Bluefish5/Nano/Documents/PCB schematic/PROC NANO.png

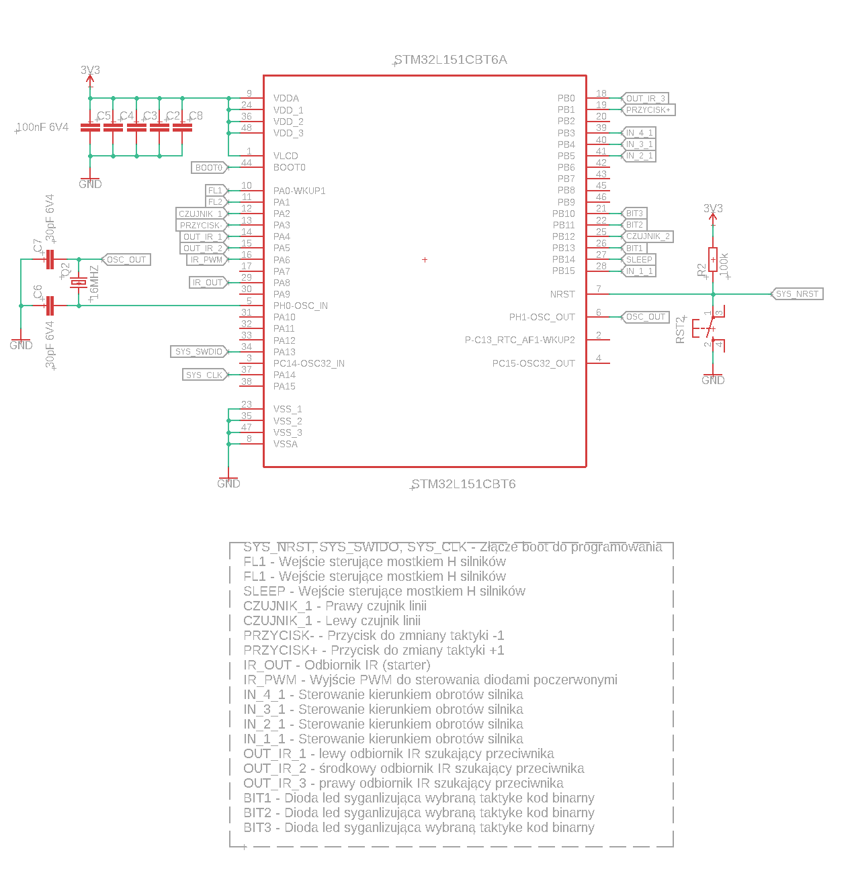
Documents/PCB schematic/PROC NANO.png
