Bluefish5/Nano/Documents/PCB schematic/PCB-dol.brd

## EAGLE design Documents/PCB schematic/PCB-dol.brd (2022-12-02)

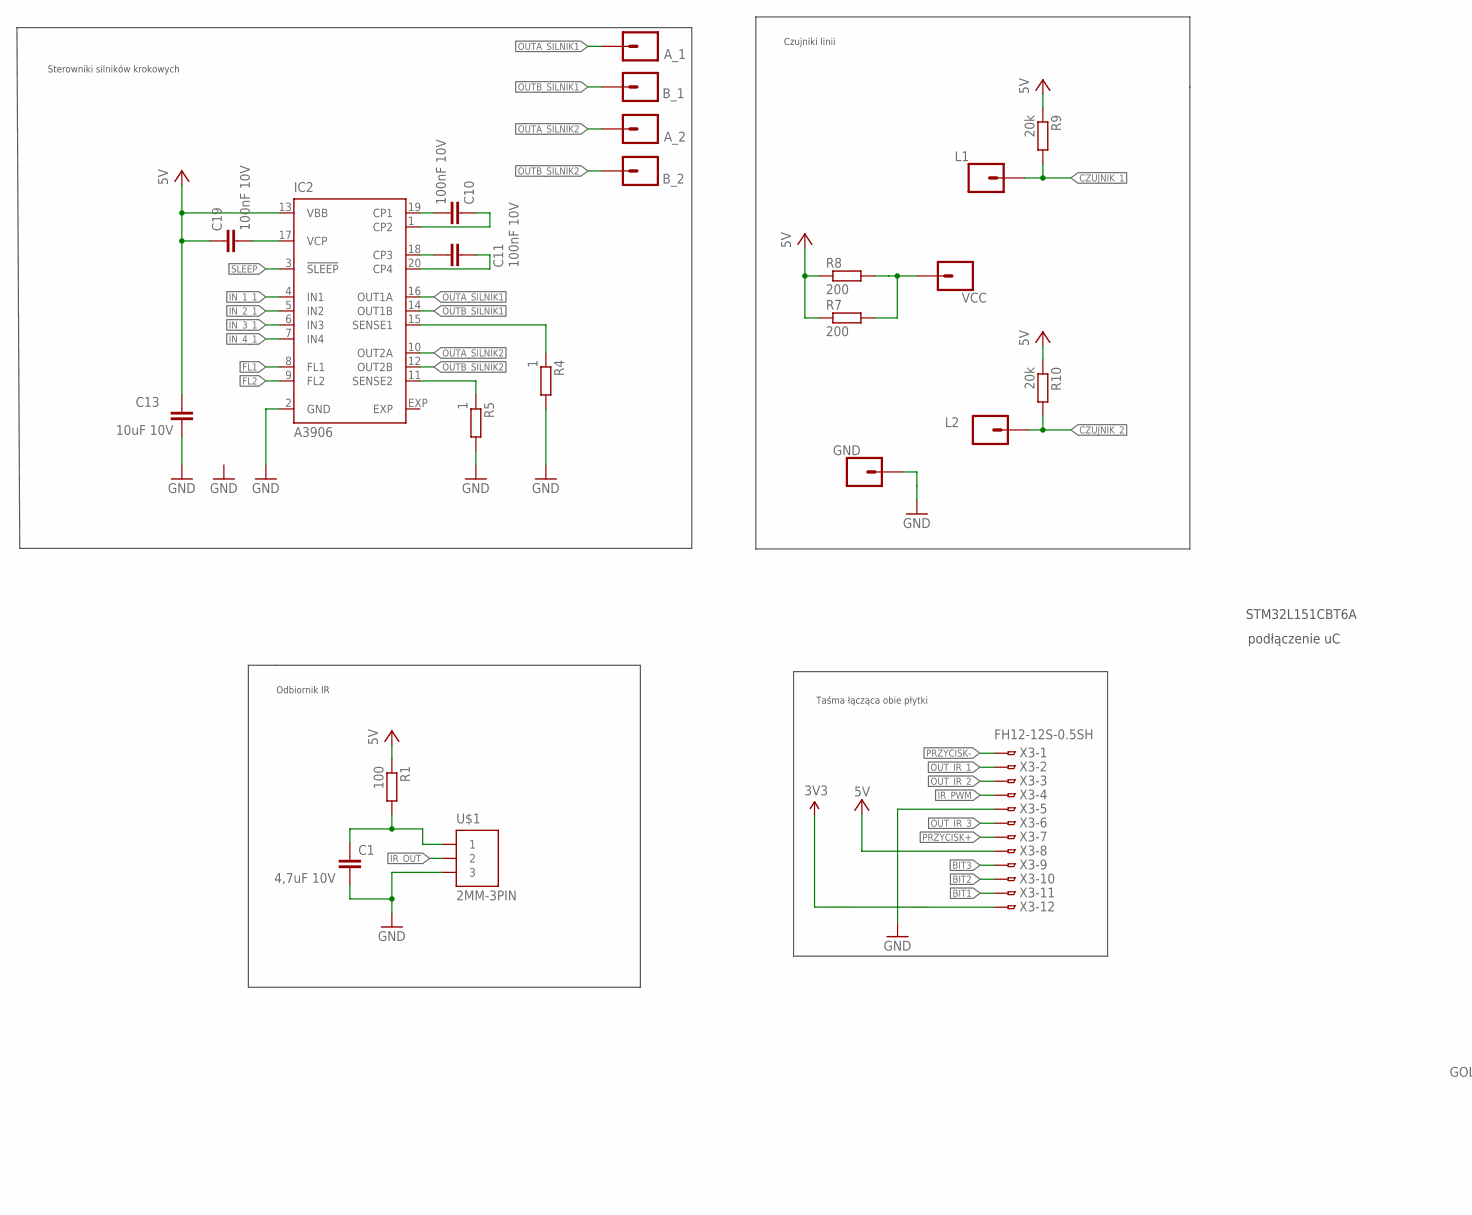
[picture p2: schematic PCB-dol.sch, part in row 1, column 1]

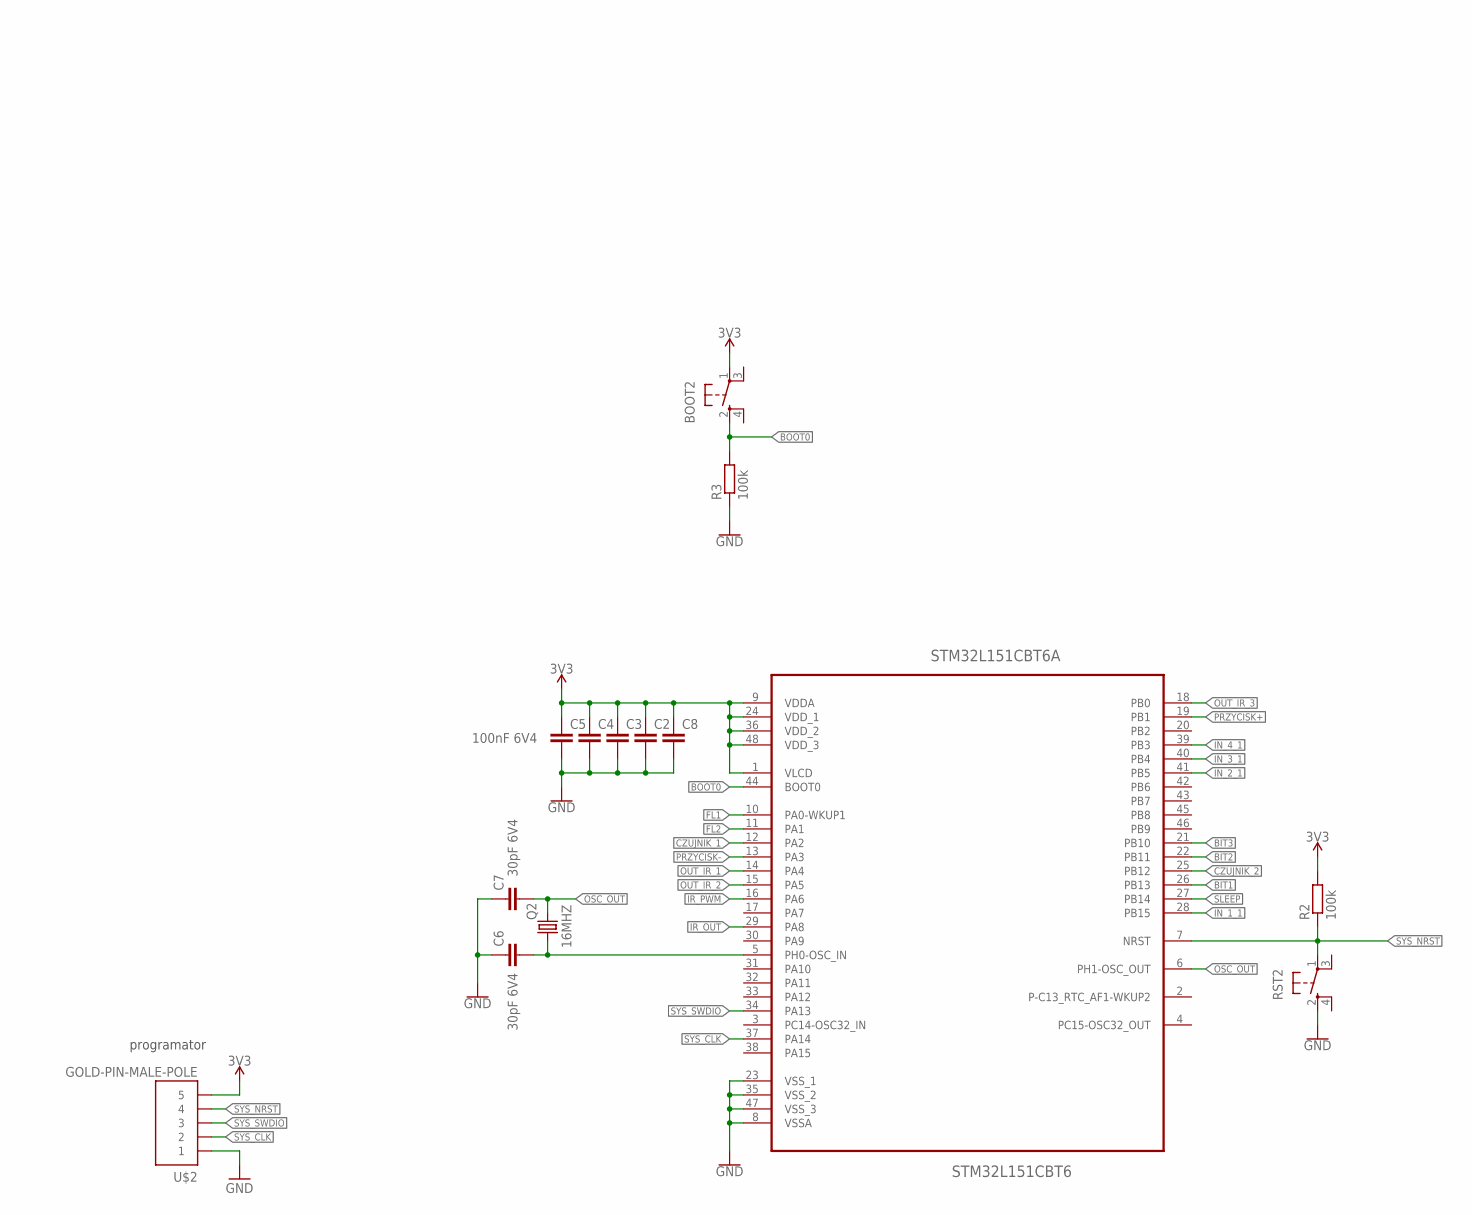
[picture p3: schematic PCB-dol.sch, part in row 1, column 2]

Parts:
A_1, A_2: CONN_01PTH_NO_SILK_KIT; 1X01NS_KIT
BOOT2: SPST_TACT-KMR2; KMR2
B_1, B_2: CONN_01PTH_NO_SILK_KIT; 1X01NS_KIT
C1: 4,7uF 10V; C0402
C2, C3, C4, C5, C8: 100nF 6V4; C0402
C6, C7: 30pF 6V4; C0402
C10, C11, C19: 100nF 10V; C0402
C13: 10uF 10V; C0402
GND: CONN_01PTH_NO_SILK_KIT; 1X01NS_KIT
IC2: A3906; QFN20
L1, L2: CONN_01PTH_NO_SILK_KIT; 1X01NS_KIT
Q2: 16MHZ; 3.2X2.5_KX-7
R1: 100; R0402
R2, R3: 100k; R0402
R4, R5: 1; R0402
R7, R8: 200; R0805
R9, R10: 20k; R0402
RST2: SPST_TACT-KMR2; KMR2
STM32L151CBT6A: STM32L151CBT6; QFP50P900X900X160-48N
U$1: 2MM-3PIN
U$2: GOLD-PIN-MALE-POLE; PIN5
VCC: CONN_01PTH_NO_SILK_KIT; 1X01NS_KIT
X3: FH12-12S-0.5SH

Connections:
3.3V: BOOT2.1, C2.1, C3.1, C4.1, C5.1, C8.1, R2.2, STM32L151CBT6A.1 (VLCD), STM32L151CBT6A.9 (VDDA), STM32L151CBT6A.24 (VDD_1), STM32L151CBT6A.36 (VDD_2), STM32L151CBT6A.48 (VDD_3), U$2.P$5 (5), X3.12
BIT1: STM32L151CBT6A.26 (PB13), X3.11
BIT2: STM32L151CBT6A.22 (PB11), X3.10
BIT3: STM32L151CBT6A.21 (PB10), X3.9
BOOT0: BOOT2.2 (S), R3.2, STM32L151CBT6A.44 (BOOT0)
CZUJNIK_1: L1.1, R9.2, STM32L151CBT6A.12 (PA2)
CZUJNIK_2: L2.1, R10.2, STM32L151CBT6A.25 (PB12)
FL1: IC2.8 (FL1), STM32L151CBT6A.10 (PA0-WKUP1)
FL2: IC2.9 (FL2), STM32L151CBT6A.11 (PA1)
GND: C1.2, C2.2, C3.2, C4.2, C5.2, C6.1, C7.1, C8.2, C13.1, GND.1, IC2.2 (GND), R3.1, R4.2, R5.2, RST2.2 (S), STM32L151CBT6A.8 (VSSA), STM32L151CBT6A.23 (VSS_1), STM32L151CBT6A.35 (VSS_2), STM32L151CBT6A.47 (VSS_3), U$1.P$3 (3), U$2.P$1 (1), X3.5
IN_1_1: IC2.4 (IN1), STM32L151CBT6A.28 (PB15)
IN_2_1: IC2.5 (IN2), STM32L151CBT6A.41 (PB5)
IN_3_1: IC2.6 (IN3), STM32L151CBT6A.40 (PB4)
IN_4_1: IC2.7 (IN4), STM32L151CBT6A.39 (PB3)
IR_OUT: STM32L151CBT6A.29 (PA8), U$1.P$2 (2)
IR_PWM: STM32L151CBT6A.16 (PA6), X3.4
unnamed: C6.2, Q2.1, STM32L151CBT6A.5 (PH0-OSC_IN)
unnamed: C1.1, R1.2, U$1.P$1 (1)
unnamed: IC2.11 (SENSE2), R5.1
unnamed: C10.2, IC2.1 (CP2)
unnamed: C11.2, IC2.20 (CP4)
unnamed: IC2.15 (SENSE1), R4.1
unnamed: R7.2, R8.2, VCC.1
unnamed: C10.1, IC2.19 (CP1)
unnamed: C11.1, IC2.18 (CP3)
unnamed: C19.1, IC2.17 (VCP)
OSC_OUT: C7.2, Q2.3 (2), STM32L151CBT6A.6 (PH1-OSC_OUT)
OUTA_SILNIK1: A_1.1, IC2.16 (OUT1A)
OUTA_SILNIK2: A_2.1, IC2.10 (OUT2A)
OUTB_SILNIK1: B_1.1, IC2.14 (OUT1B)
OUTB_SILNIK2: B_2.1, IC2.12 (OUT2B)
OUT_IR_1: STM32L151CBT6A.14 (PA4), X3.2
OUT_IR_2: STM32L151CBT6A.15 (PA5), X3.3
OUT_IR_3: STM32L151CBT6A.18 (PB0), X3.6
PRZYCISK+: STM32L151CBT6A.19 (PB1), X3.7
PRZYCISK-: STM32L151CBT6A.13 (PA3), X3.1
SLEEP: IC2.3 (!SLEEP), STM32L151CBT6A.27 (PB14)
SYS_CLK: STM32L151CBT6A.37 (PA14), U$2.P$2 (2)
SYS_NRST: R2.1, RST2.1, STM32L151CBT6A.7 (NRST), U$2.P$4 (4)
SYS_SWDIO: STM32L151CBT6A.34 (PA13), U$2.P$3 (3)
VCC: C13.2, C19.2, IC2.13 (VBB), R1.1, R7.1, R8.1, R9.1, R10.1, X3.8

Notes on the sheet:
Sterowniki silników krokowych
programator
podłączenie uC
Odbiornik IR
Czujniki linii
Taśma łącząca obie płytki
STM32L151CBT6A

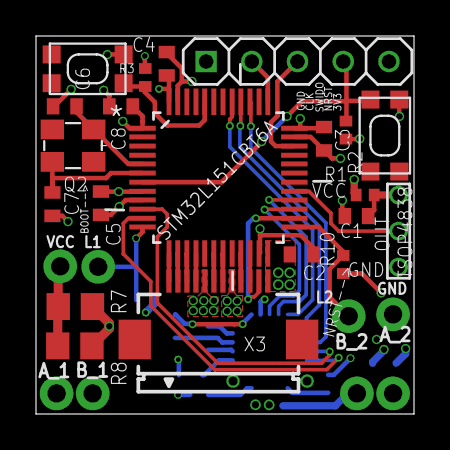
[picture p4: board PCB-dol.brd from above]

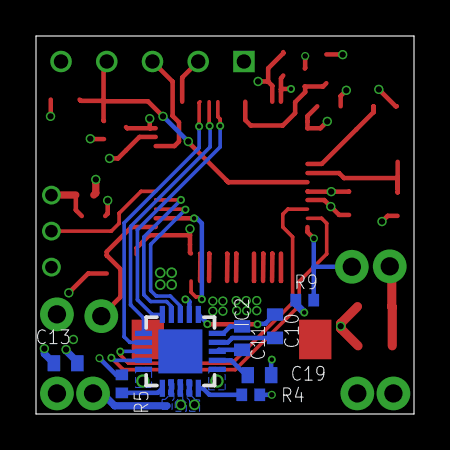
[picture p5: board PCB-dol.brd from below]

Board: 4 copper layers, 21.0 x 21.0 mm, 37 parts (8 on the bottom side), 41 nets.
