Bluefish5/Nano/Documents/PCB schematic/PCB.brd

## EAGLE design Documents/PCB schematic/PCB.brd (2022-12-02)

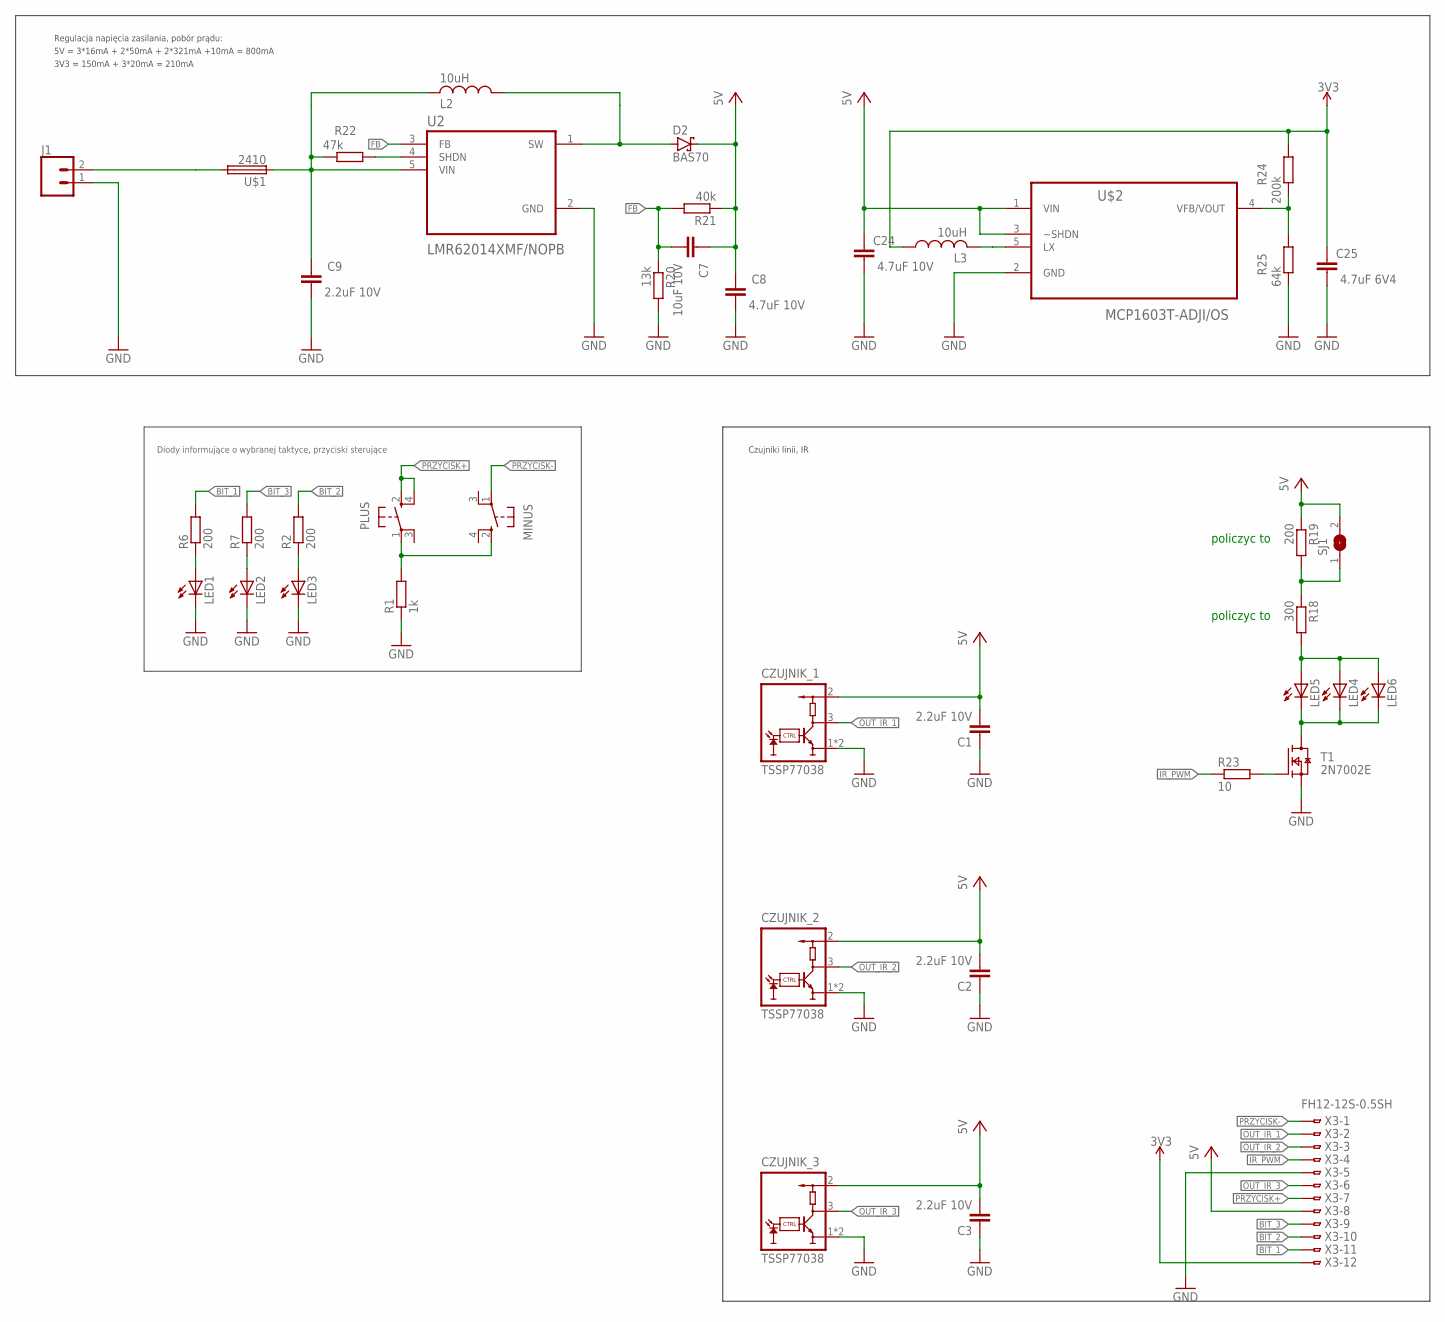
[picture p6: schematic PCB.sch, sheet 1]

Parts:
C1, C2, C3, C9: 2.2uF 10V; C0402
C7: 10uF 10V; C0402
C8, C24: 4.7uF 10V; C0402
C25: 4.7uF 6V4; C0402
CZUJNIK_1, CZUJNIK_2, CZUJNIK_3: TSSP77038
D2: BAS70; SOT23
J1: CONN_02POLAR_LOCK; MOLEX-1X2_LOCK
L2: 10uH; DJNR5020
L3: 10uH; L1812
LED1, LED2, LED3: LEDCHIP-LED0603; CHIP-LED0603
LED4, LED5, LED6: LED3MM
MINUS: SPST_TACT-KMR2; KMR2
PLUS: SPST_TACT-KMR2; KMR2
R1: 1k; R0402
R2, R6, R7: 200; R0805
R18: 300; R0402
R19: 200; R0402
R20: 13k; R0402
R21: 40k; R0402
R22: 47k; R0402
R23: 10; R0402
R24: 200k; R0402
R25: 64k; R0402
SJ1: SJ
T1: 2N7002E; SOT23
U2: LMR62014XMF/NOPB; SOT95P280X145-5N
U$1: 2410
U$2: MCP1603T-ADJI/OS; SOT95P280X110-5N
X3: FH12-12S-0.5SH

Connections:
3.3V: C25.2, L3.1, R24.1, X3.12
BIT_1: R6.2, X3.11
BIT_2: R2.2, X3.10
BIT_3: R7.2, X3.9
FB: C7.1, R20.1, R21.2, U2.3 (FB)
GND: C1.1, C2.1, C3.1, C8.1, C9.1, C24.1, C25.1, CZUJNIK_1.1 (GND), CZUJNIK_1.4 (GND), CZUJNIK_2.1 (GND), CZUJNIK_2.4 (GND), CZUJNIK_3.1 (GND), CZUJNIK_3.4 (GND), J1.1, LED1.C, LED2.C, LED3.C, R1.1, R20.2, R25.2, T1.2 (S), U2.2 (GND), U$2.2 (GND), X3.5
IR_PWM: R23.1, X3.4
unnamed: MINUS.2 (S), PLUS.1, R1.2
unnamed: LED2.A, R7.1
unnamed: LED3.A, R2.1
unnamed: LED1.A, R6.1
unnamed: C1.2, CZUJNIK_1.2 (VS)
unnamed: C3.2, CZUJNIK_3.2 (VS)
unnamed: C2.2, CZUJNIK_2.2 (VS)
unnamed: LED4.K (C), LED5.K (C), LED6.K (C), T1.3 (D)
unnamed: D2.1 (A), L2.P$1 (1), U2.1 (SW)
unnamed: R18.1, R19.2, SJ1.1
unnamed: LED4.A, LED5.A, LED6.A, R18.2
unnamed: R22.1, U2.4 (SHDN)
unnamed: J1.2, U$1.2
unnamed: C9.2, L2.P$2 (2), R22.2, U2.5 (VIN), U$1.1
unnamed: R23.2, T1.1 (G)
unnamed: L3.2, U$2.5 (LX)
unnamed: R24.2, R25.1, U$2.4 (VFB/VOUT)
OUT_IR_1: CZUJNIK_1.3 (OUT), X3.2
OUT_IR_2: CZUJNIK_2.3 (OUT), X3.3
OUT_IR_3: CZUJNIK_3.3 (OUT), X3.6
PRZYCISK+: PLUS.2 (S), PLUS.4 (S1), X3.7
PRZYCISK-: MINUS.1, X3.1
VCC: C7.2, C8.2, C24.2, D2.3 (C), R19.1, R21.1, SJ1.2, U$2.1 (VIN), U$2.3 (~SHDN), X3.8

Notes on the sheet:
Diody informujące o wybranej taktyce, przyciski sterujące
policzyc to
3V3 = 150mA + 3*20mA = 210mA
5V = 3*16mA + 2*50mA + 2*321mA +10mA = 800mA
Regulacja napięcia zasilania, pobór prądu:
Czujniki linii, IR

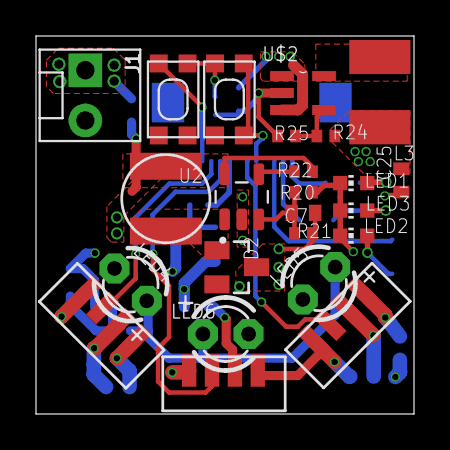
[picture p7: board PCB.brd from above]

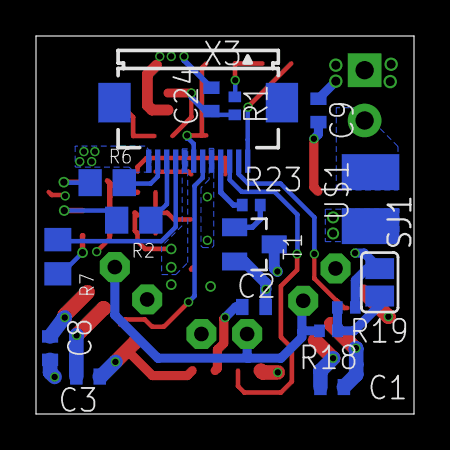
[picture p8: board PCB.brd from below]

Board: 4 copper layers, 21.0 x 21.0 mm, 41 parts (17 on the bottom side), 30 nets.
