Bluefish5/Nano/Core/Src/main.c

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
/* Includes ------------------------------------------------------------------*/
#include "main.h"

ADC_HandleTypeDef hadc;

TIM_HandleTypeDef htim1;
TIM_HandleTypeDef htim3;

/* USER CODE BEGIN PV */
volatile static uint16_t sensor_value[3];

uint8_t line_sensor_1_value;
uint8_t line_sensor_2_value;

uint8_t button_1_value;
uint8_t button_2_value;

uint32_t tempCode;
uint8_t bitIndex;
uint8_t cmd;
uint8_t cmdli;
uint32_t code;



/* USER CODE END PV */

void SystemClock_Config(void);
static void MX_GPIO_Init(void);
static void MX_ADC_Init(void);
static void MX_TIM3_Init(void);
static void MX_TIM1_Init(void);
/* USER CODE BEGIN 0 */
void HAL_TIM_PeriodElapsedCallback(TIM_HandleTypeDef *htim)
{
  if (htim == &htim3) {
    HAL_GPIO_TogglePin(IR_PWM_GPIO_Port, IR_PWM_Pin);
    //HAL_GPIO_TogglePin(LED_1_GPIO_Port, LED_1_Pin);
  }
}

void motorBreak()
{
	HAL_GPIO_WritePin(H_BRIDGE_IN_1_GPIO_Port, H_BRIDGE_IN_1_Pin, GPIO_PIN_RESET);
	HAL_GPIO_WritePin(H_BRIDGE_IN_2_GPIO_Port, H_BRIDGE_IN_2_Pin, GPIO_PIN_RESET);
	HAL_GPIO_WritePin(H_BRIDGE_IN_3_GPIO_Port, H_BRIDGE_IN_3_Pin, GPIO_PIN_RESET);
	HAL_GPIO_WritePin(H_BRIDGE_IN_4_GPIO_Port, H_BRIDGE_IN_4_Pin, GPIO_PIN_RESET);
}
void motorRevers()
{
	HAL_GPIO_WritePin(H_BRIDGE_IN_1_GPIO_Port, H_BRIDGE_IN_1_Pin, GPIO_PIN_RESET);
	HAL_GPIO_WritePin(H_BRIDGE_IN_2_GPIO_Port, H_BRIDGE_IN_2_Pin, GPIO_PIN_SET);
	HAL_GPIO_WritePin(H_BRIDGE_IN_3_GPIO_Port, H_BRIDGE_IN_3_Pin, GPIO_PIN_SET);
	HAL_GPIO_WritePin(H_BRIDGE_IN_4_GPIO_Port, H_BRIDGE_IN_4_Pin, GPIO_PIN_RESET);
}
void motorRotationRight()
{
	HAL_GPIO_WritePin(H_BRIDGE_IN_1_GPIO_Port, H_BRIDGE_IN_1_Pin, GPIO_PIN_SET);
	HAL_GPIO_WritePin(H_BRIDGE_IN_2_GPIO_Port, H_BRIDGE_IN_2_Pin, GPIO_PIN_RESET);
	HAL_GPIO_WritePin(H_BRIDGE_IN_3_GPIO_Port, H_BRIDGE_IN_3_Pin, GPIO_PIN_SET);
	HAL_GPIO_WritePin(H_BRIDGE_IN_4_GPIO_Port, H_BRIDGE_IN_4_Pin, GPIO_PIN_RESET);
}
void motorRotationLeft()
{
	HAL_GPIO_WritePin(H_BRIDGE_IN_1_GPIO_Port, H_BRIDGE_IN_1_Pin, GPIO_PIN_RESET);
	HAL_GPIO_WritePin(H_BRIDGE_IN_2_GPIO_Port, H_BRIDGE_IN_2_Pin, GPIO_PIN_SET);
	HAL_GPIO_WritePin(H_BRIDGE_IN_3_GPIO_Port, H_BRIDGE_IN_3_Pin, GPIO_PIN_RESET);
	HAL_GPIO_WritePin(H_BRIDGE_IN_4_GPIO_Port, H_BRIDGE_IN_4_Pin, GPIO_PIN_SET);
}
void motorForward()
{
	HAL_GPIO_WritePin(H_BRIDGE_IN_1_GPIO_Port, H_BRIDGE_IN_1_Pin, GPIO_PIN_SET);
	HAL_GPIO_WritePin(H_BRIDGE_IN_2_GPIO_Port, H_BRIDGE_IN_2_Pin, GPIO_PIN_RESET);
	HAL_GPIO_WritePin(H_BRIDGE_IN_3_GPIO_Port, H_BRIDGE_IN_3_Pin, GPIO_PIN_RESET);
	HAL_GPIO_WritePin(H_BRIDGE_IN_4_GPIO_Port, H_BRIDGE_IN_4_Pin, GPIO_PIN_SET);
}
/* USER CODE END 0 */

/**
  * @brief  The application entry point.
  * @retval int
  */
int main(void)
{
  /* MCU Configuration--------------------------------------------------------*/

  /* Reset of all peripherals, Initializes the Flash interface and the Systick. */
  HAL_Init();

  /* Configure the system clock */
  SystemClock_Config();

  /* Initialize all configured peripherals */
  MX_GPIO_Init();
  MX_ADC_Init();
  MX_TIM3_Init();
  MX_TIM1_Init();
  /* USER CODE BEGIN 2 */
  HAL_TIM_Base_Start(&htim1);
  __HAL_TIM_SET_COUNTER(&htim1, 0);

  HAL_TIM_Base_Start_IT(&htim3);

  HAL_ADC_Start(&hadc);
  HAL_ADCEx_Calibration_Start(&hadc);

  //HAL_ADCEx_Calibration_Start(&hadc);
  //HAL_ADC_Start_DMA(&hadc, (uint32_t*)sensor_value, 3);

  /* USER CODE END 2 */

  /* Infinite loop */
  /* USER CODE BEGIN WHILE */

  while (1)
  {

	  HAL_ADC_PollForConversion(&hadc, HAL_MAX_DELAY);
	  sensor_value[0] = HAL_ADC_GetValue(&hadc);


	  HAL_ADC_PollForConversion(&hadc, HAL_MAX_DELAY);
	  sensor_value[1] = HAL_ADC_GetValue(&hadc);


	  HAL_ADC_PollForConversion(&hadc, HAL_MAX_DELAY);
	  sensor_value[2] = HAL_ADC_GetValue(&hadc);

	  line_sensor_1_value = HAL_GPIO_ReadPin(LINE_SENSOR_1_GPIO_Port,LINE_SENSOR_1_Pin);
	  line_sensor_2_value = HAL_GPIO_ReadPin(LINE_SENSOR_2_GPIO_Port,LINE_SENSOR_2_Pin);

	  if(code==1086290565)// sprawdza czy robor otrzymał start
	  {
		  while(1)
		  {
			  if(code==1086290055){while(1){motorBreak();}}
			  motorForward();


			  HAL_ADC_PollForConversion(&hadc, HAL_MAX_DELAY);
			  sensor_value[0] = HAL_ADC_GetValue(&hadc);


			  HAL_ADC_PollForConversion(&hadc, HAL_MAX_DELAY);
			  sensor_value[1] = HAL_ADC_GetValue(&hadc);


			  HAL_ADC_PollForConversion(&hadc, HAL_MAX_DELAY);
			  sensor_value[2] = HAL_ADC_GetValue(&hadc);

			  line_sensor_1_value = HAL_GPIO_ReadPin(LINE_SENSOR_1_GPIO_Port,LINE_SENSOR_1_Pin);
			  line_sensor_2_value = HAL_GPIO_ReadPin(LINE_SENSOR_2_GPIO_Port,LINE_SENSOR_2_Pin);


			  if(sensor_value[2]<=2200)motorForward();
			  else if(sensor_value[0]<=2200)motorRotationLeft();
			  else if(sensor_value[1]<=2200)motorRotationRight();
			  else if(line_sensor_1_value==0)
			  {
				  motorRevers();
				  HAL_Delay(500);
				  motorRotationLeft();
				  HAL_Delay(500);
				  motorBreak();
			  }
			  else if(line_sensor_2_value==0)
			  {
				  motorRevers();
				  HAL_Delay(500);
				  motorRotationRight();
				  HAL_Delay(500);
				  motorBreak();
			  }
			  else motorForward();

		  }

	  }
    /* USER CODE END WHILE */

    /* USER CODE BEGIN 3 */
  }
  /* USER CODE END 3 */
}

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
/* USER CODE BEGIN 4 */

void HAL_GPIO_EXTI_Callback(uint16_t GPIO_Pin)
{
  if(GPIO_Pin == STARTER_Pin)
  {
    if (__HAL_TIM_GET_COUNTER(&htim1) > 8000)
    {
      tempCode = 0;
      bitIndex = 0;
    }
    else if (__HAL_TIM_GET_COUNTER(&htim1) > 1700)
    {
      tempCode |= (1UL << (31-bitIndex));   // write 1
      bitIndex++;
    }
    else if (__HAL_TIM_GET_COUNTER(&htim1) > 1000)
    {
      tempCode &= ~(1UL << (31-bitIndex));  // write 0
      bitIndex++;
    }
    if(bitIndex == 32)
    {
      cmdli = ~tempCode; // Logical inverted last 8 bits
      cmd = tempCode >> 8; // Second last 8 bits
      if(cmdli == cmd) // Check for errors
      {
        code = tempCode; // If no bit errors
      }
      bitIndex = 0;
    }
    __HAL_TIM_SET_COUNTER(&htim1, 0);
  }
}
/* USER CODE END 4 */
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
