Bluefish5/Nano/Core/Inc/main.h

#define H_BRIDGE_FL_1_Pin GPIO_PIN_0
#define H_BRIDGE_FL_1_GPIO_Port GPIOA
#define H_BRIDGE_FL_2_Pin GPIO_PIN_1
#define H_BRIDGE_FL_2_GPIO_Port GPIOA
#define LINE_SENSOR_1_Pin GPIO_PIN_2
#define LINE_SENSOR_1_GPIO_Port GPIOA
#define BUTTON_2_Pin GPIO_PIN_3
#define BUTTON_2_GPIO_Port GPIOA
#define SENSOR_1_Pin GPIO_PIN_4
#define SENSOR_1_GPIO_Port GPIOA
#define SENSOR_2_Pin GPIO_PIN_5
#define SENSOR_2_GPIO_Port GPIOA
#define IR_PWM_Pin GPIO_PIN_6
#define IR_PWM_GPIO_Port GPIOA
#define SENSOR_3_Pin GPIO_PIN_0
#define SENSOR_3_GPIO_Port GPIOB
#define BUTTON_1_Pin GPIO_PIN_1
#define BUTTON_1_GPIO_Port GPIOB
#define LED_3_Pin GPIO_PIN_10
#define LED_3_GPIO_Port GPIOB
#define LED_2_Pin GPIO_PIN_11
#define LED_2_GPIO_Port GPIOB
#define LINE_SENSOR_2_Pin GPIO_PIN_12
#define LINE_SENSOR_2_GPIO_Port GPIOB
#define LED_1_Pin GPIO_PIN_13
#define LED_1_GPIO_Port GPIOB
#define H_BRIDGE_SLEEP_Pin GPIO_PIN_14
#define H_BRIDGE_SLEEP_GPIO_Port GPIOB
#define H_BRIDGE_IN_1_Pin GPIO_PIN_15
#define H_BRIDGE_IN_1_GPIO_Port GPIOB
#define STARTER_Pin GPIO_PIN_8
#define STARTER_GPIO_Port GPIOA
#define STARTER_EXTI_IRQn EXTI4_15_IRQn
#define H_BRIDGE_IN_4_Pin GPIO_PIN_3
#define H_BRIDGE_IN_4_GPIO_Port GPIOB
#define H_BRIDGE_IN_3_Pin GPIO_PIN_4
#define H_BRIDGE_IN_3_GPIO_Port GPIOB
#define H_BRIDGE_IN_2_Pin GPIO_PIN_5
#define H_BRIDGE_IN_2_GPIO_Port GPIOB
