Bluefish5/Nano/(commit log)

2022-12-02 Innit 🛠
    [PCB dol.brd, PCB dol.sch, PCB-dol.brd, PCB-dol.sch, PCB.brd, PCB.sch]
2022-12-02 Piwnica - 02.12.22
    [PCB dol.brd, PCB dol.sch]
