Bluefish5/Nano/(notices)

Notices in the files:
Core/Src/main.c:
Copyright (c) 2022 STMicroelectronics.
All rights reserved.
This software is licensed under terms that can be found in the LICENSE file
parts and their libraries:
SparkFun-PowerSymbols: Licensing: Creative Commons ShareAlike 4.0 International - https://creativecommons.org/licenses/by-sa/4.0
NXP_60_26022015: This library may be distributed and adapted freely for any purpose, as long as NXP is credited and any new creation is licensed under the same terms.
